NEType24443/Vehicle-Crash-Detection-System/images/esp32-dev.jpg

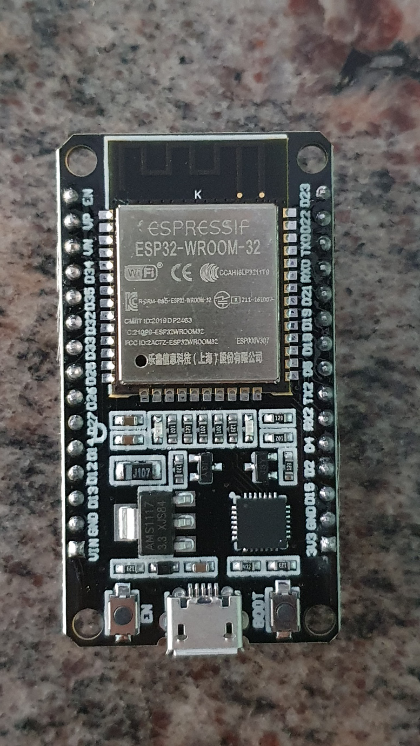
images/esp32-dev.jpg
