NEType24443/Vehicle-Crash-Detection-System/images/neo-6m.jpg

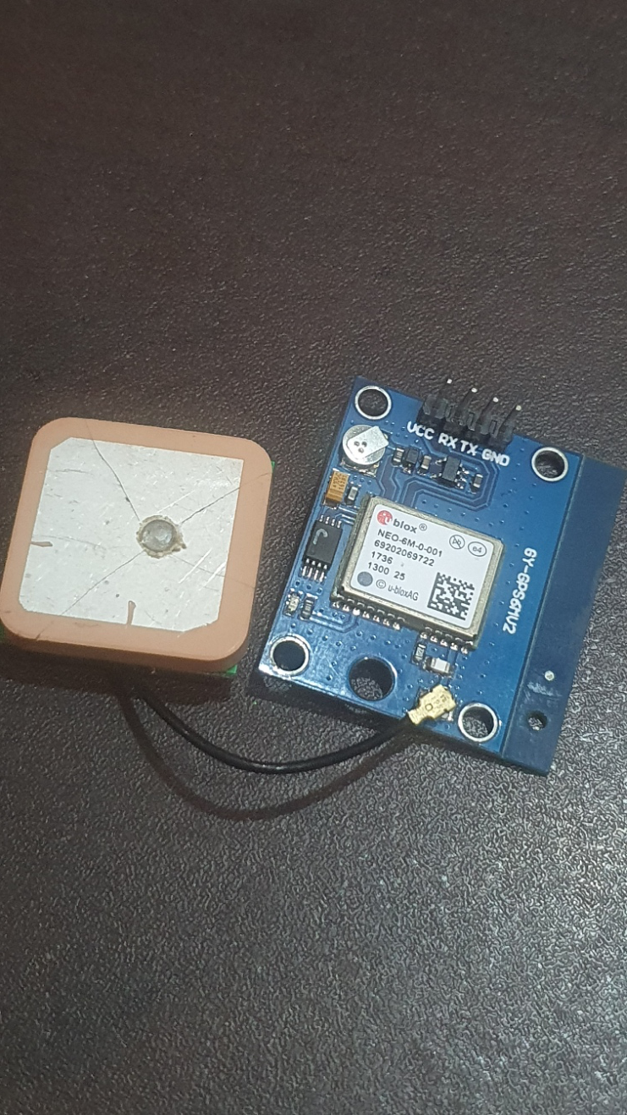
images/neo-6m.jpg
