NEType24443/Vehicle-Crash-Detection-System/images/sim800l.jpg

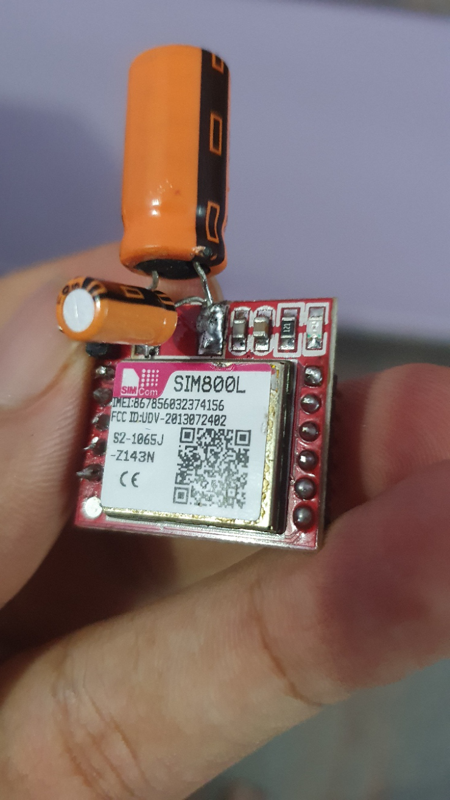
images/sim800l.jpg
