NEType24443/Vehicle-Crash-Detection-System/images/version_1.gif

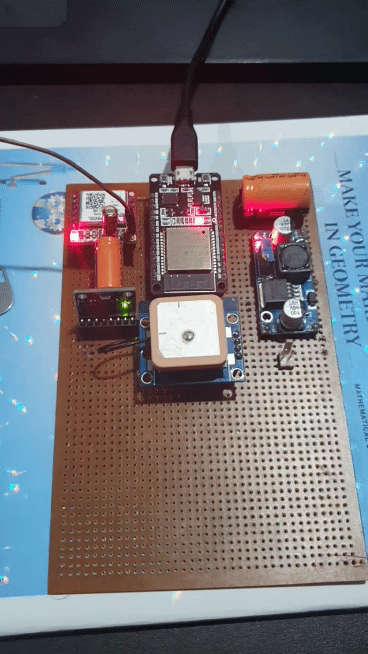
images/version_1.gif
